asrob-uc3m/ASROB-sumo/hardware/Parts v2/Wheel_v2.FCStd

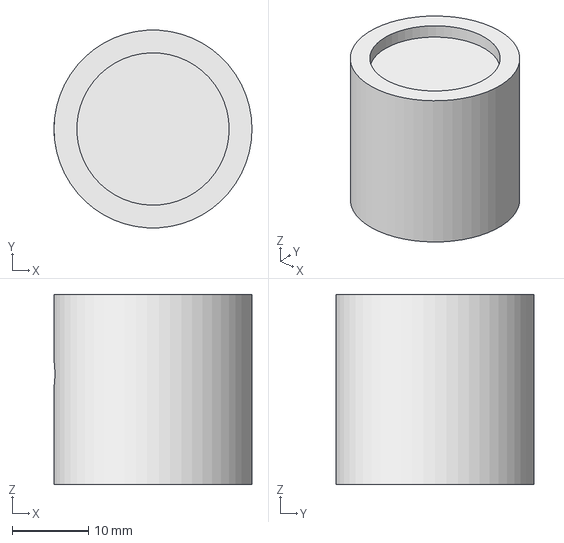
[picture p1: CAD file, 2018-10-18]
hardware/Parts v2/Wheel_v2.FCStd
26.0 x 26.0 x 25.0 mm
