asrob-uc3m/ASROB-sumo/hardware/Printables v2/Engine Bracket_v2.stl

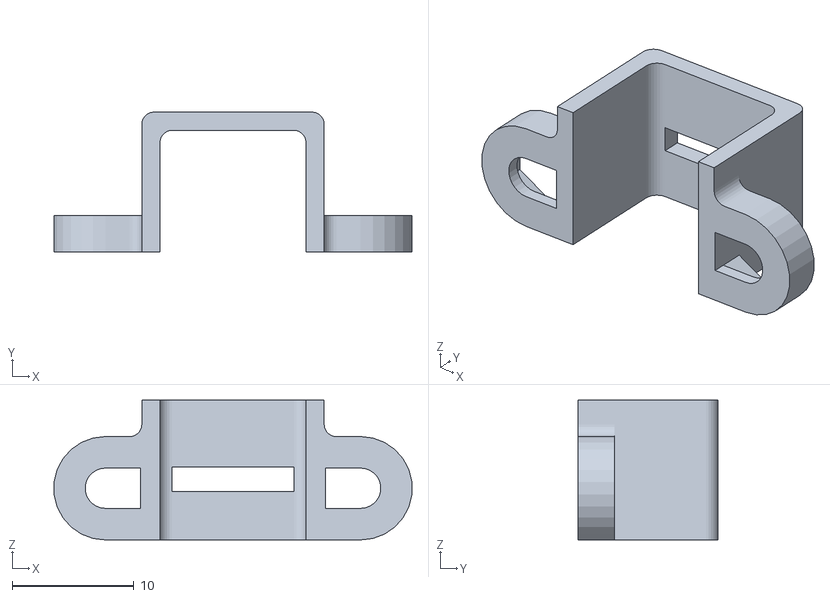
[picture p2: CAD file, 2018-10-18]
hardware/Printables v2/Engine Bracket_v2.stl
29.4 x 11.5 x 11.5
