asrob-uc3m/ASROB-sumo/hardware/Parts v2/Base2_v2.FCStd

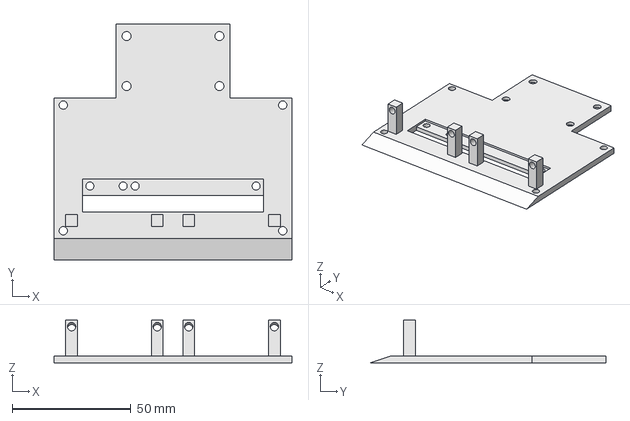
[picture p3: CAD file, 2018-10-18]
hardware/Parts v2/Base2_v2.FCStd
100.0 x 99.0 x 18.0 mm
