asrob-uc3m/ASROB-sumo/hardware/Parts v1/Assembly.FCStd

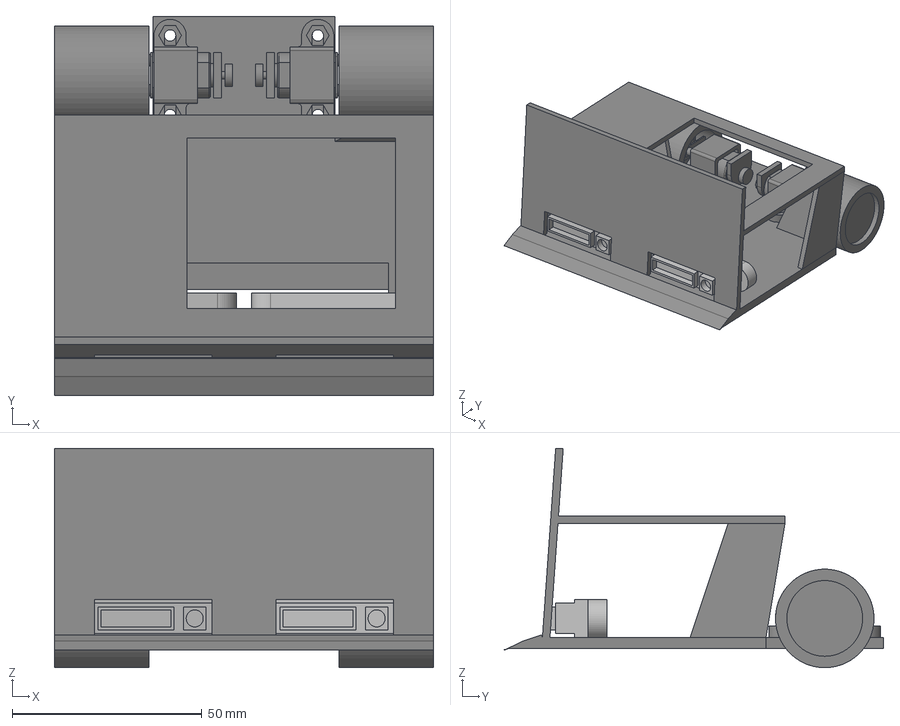
[picture p4: CAD file, 2018-04-15, an earlier design]
hardware/Parts v1/Assembly.FCStd
100.0 x 100.0 x 57.9 mm
