asrob-uc3m/ASROB-sumo/hardware/Parts v1/Sensor.FCStd

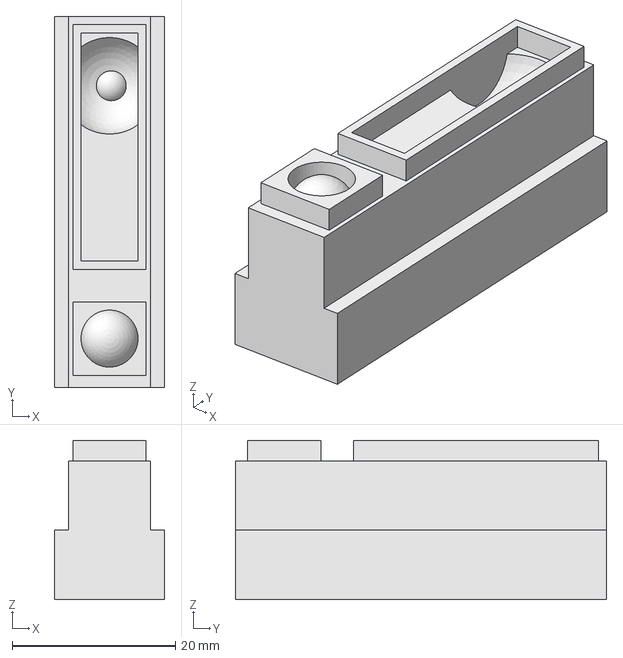
[picture p5: CAD file, 2018-04-15, an earlier design]
hardware/Parts v1/Sensor.FCStd
13.5 x 45.5 x 19.5 mm
