asrob-uc3m/ASROB-sumo/hardware/Printables v1/Structure2.stl

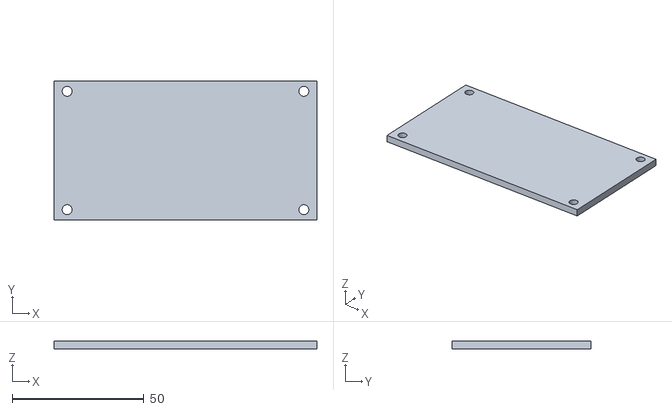
[picture p6: CAD file, 2018-04-15, an earlier design]
hardware/Printables v1/Structure2.stl
100.0 x 53.0 x 3.00
