asrob-uc3m/ASROB-sumo/hardware/Parts v1/Wheel.FCStd

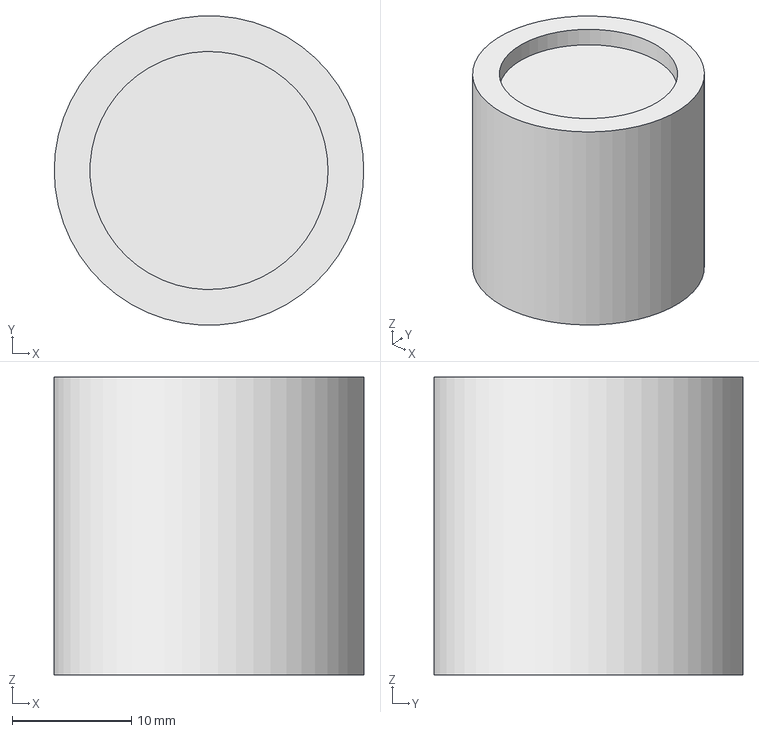
[picture p7: CAD file, 2018-04-15, an earlier design]
hardware/Parts v1/Wheel.FCStd
26.0 x 26.0 x 25.0 mm
