asrob-uc3m/ASROB-sumo/hardware/Printables v1/Structure.stl

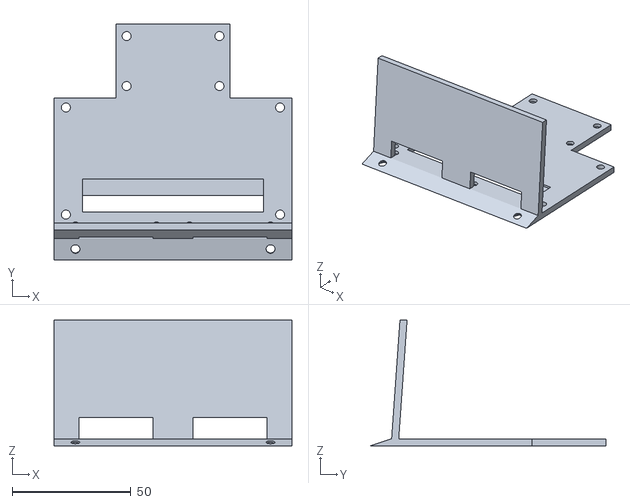
[picture p8: CAD file, 2018-04-15, an earlier design]
hardware/Printables v1/Structure.stl
100.0 x 99.0 x 52.9
