asrob-uc3m/ASROB-sumo/hardware/Parts v1/Base_extra.FCStd

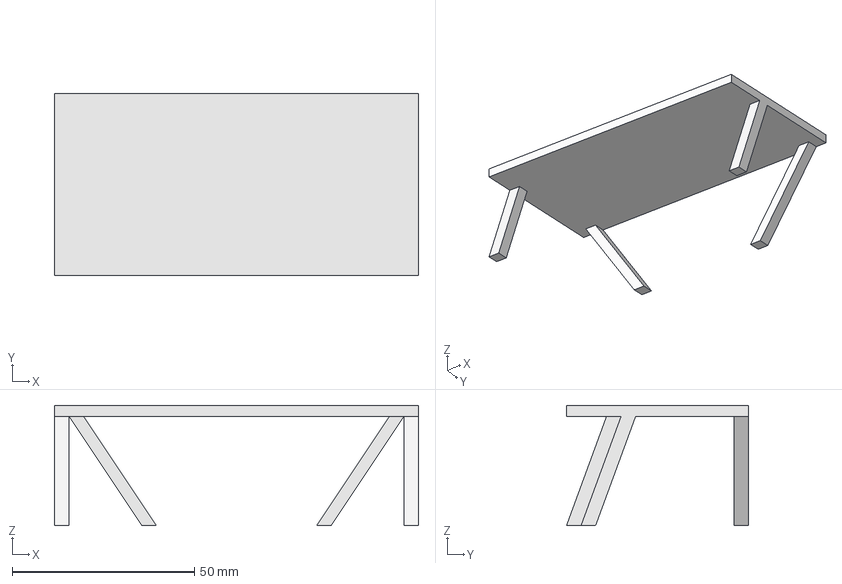
[picture p9: CAD file, 2018-04-15, an earlier design]
hardware/Parts v1/Base_extra.FCStd
100.0 x 50.0 x 33.0 mm
