asrob-uc3m/ASROB-sumo/hardware/Printables v1/Engine Bracket.stl

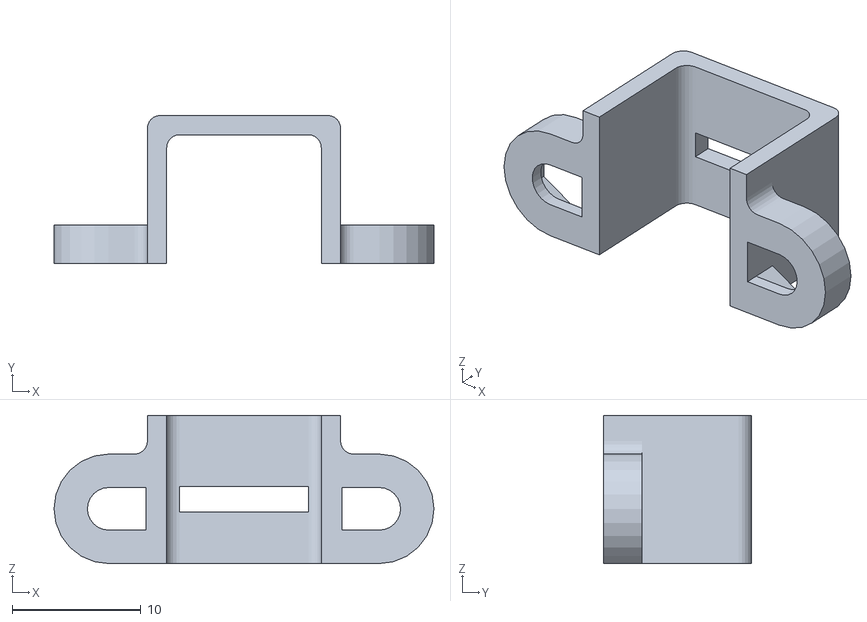
[picture p10: CAD file, 2018-04-15, an earlier design]
hardware/Printables v1/Engine Bracket.stl
29.5 x 11.5 x 11.5
