asrob-uc3m/ASROB-sumo/hardware/Parts v1/Base2.FCStd

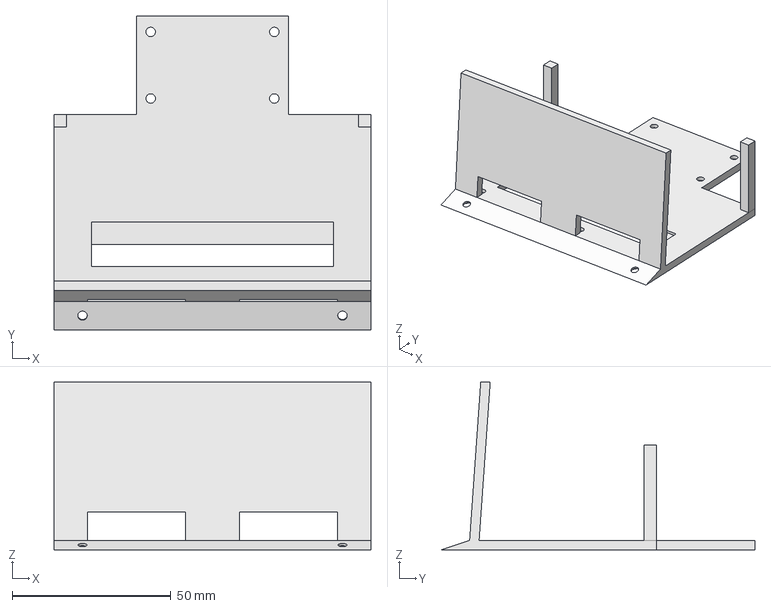
[picture p11: CAD file, 2018-04-15, an earlier design]
hardware/Parts v1/Base2.FCStd
100.0 x 99.0 x 52.9 mm
