asrob-uc3m/ASROB-sumo/hardware/Parts v1/Base.FCStd

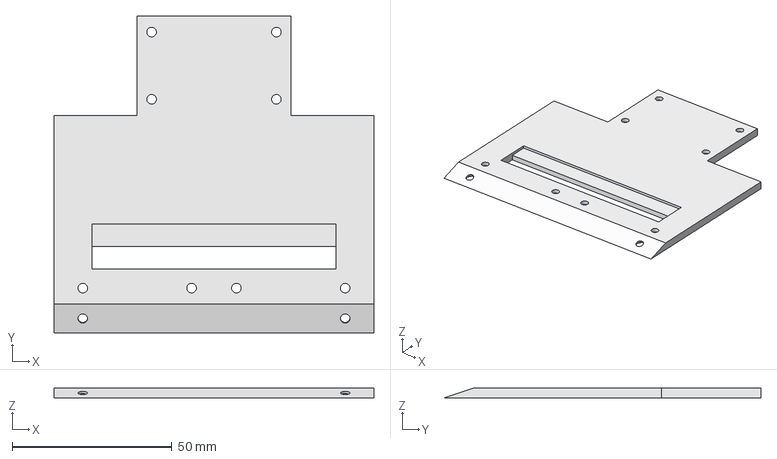
[picture p12: CAD file, 2018-04-15, an earlier design]
hardware/Parts v1/Base.FCStd
100.0 x 99.0 x 3.00 mm
