asrob-uc3m/ASROB-sumo/(list of files, cad)

Other CAD files:
hardware/Parts v2/Engine Bracket_v2.FCStd
hardware/Printables v2/Wheel_v2.stl
hardware/Printables v2/Base2_v2.stl
hardware/Printables v1/Structure2-v2.stl
hardware/Printables v1/Wheel.stl
hardware/Parts v1/Engine Bracket.FCStd
hardware/Parts v1/Blade.FCStd
hardware/Parts v1/Engine.FCStd
