asrob-uc3m/ASROB-sumo/electronics/Sumo/Sumo.kicad_pcb

## KiCad design electronics/Sumo/Sumo.kicad_pcb (2018-05-06)

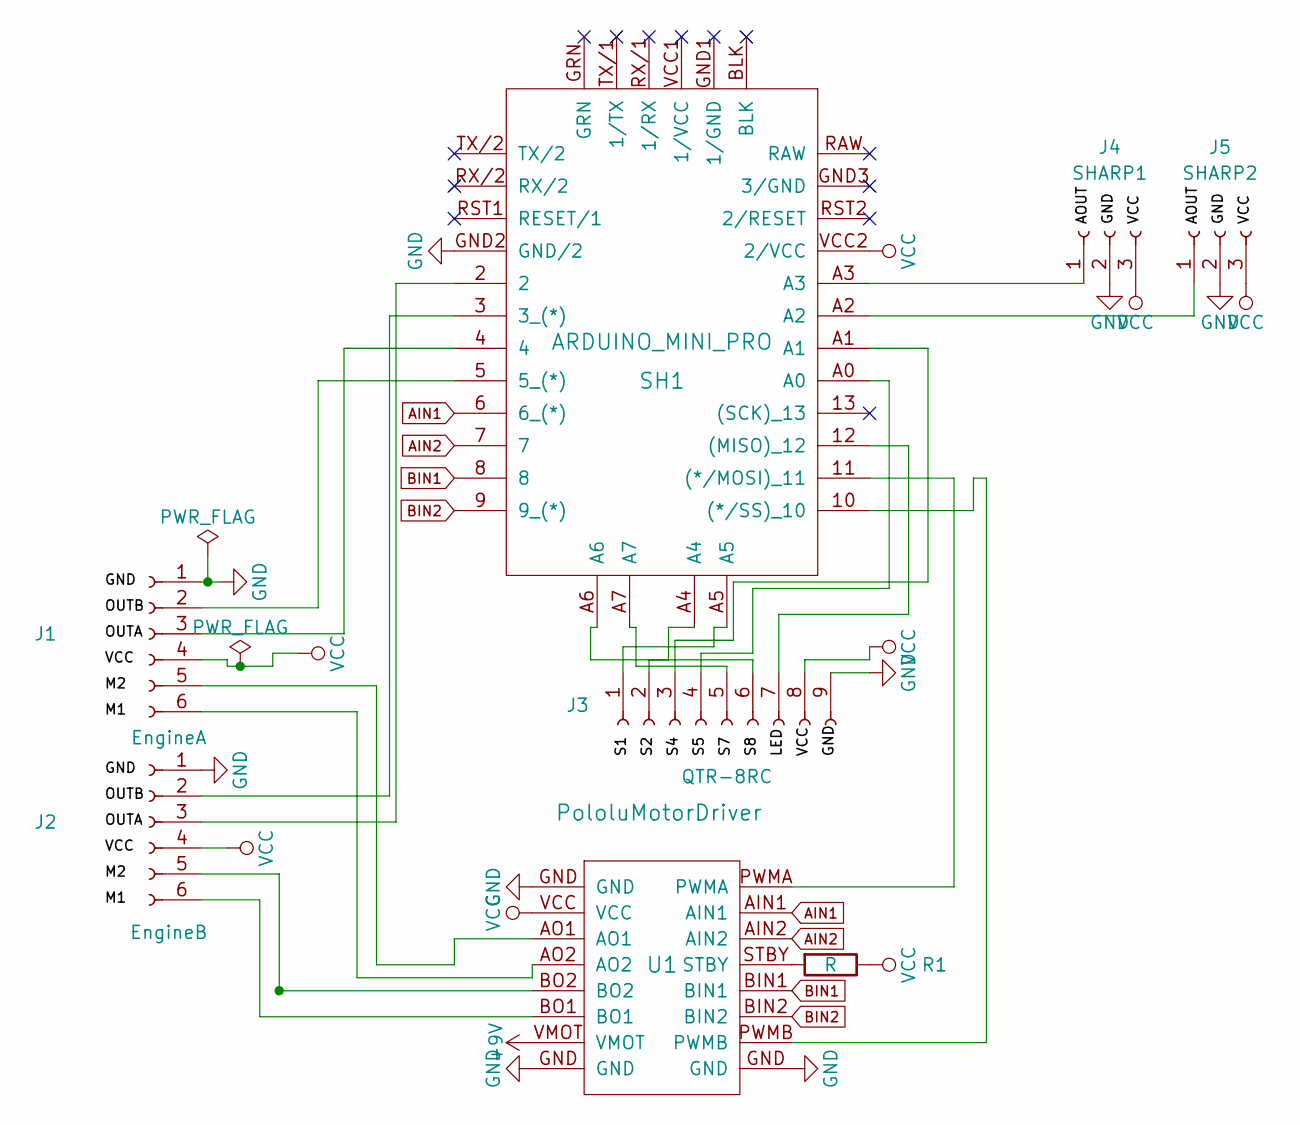
[picture p13: schematic Sumo.sch]

Parts:
J1: EngineA; Socket_Strip_Straight_1x06_Pitch2.54mm
J2: EngineB; Socket_Strip_Straight_1x06_Pitch2.54mm
J3: QTR-8RC; Socket_Strip_Straight_1x09_Pitch2.54mm
J4: SHARP1; Socket_Strip_Straight_1x03_Pitch2.54mm
J5: SHARP2; Socket_Strip_Straight_1x03_Pitch2.54mm
R1: R; R_Axial_DIN0204_L3.6mm_D1.6mm_P5.08mm_Horizontal
SH1: ARDUINO_MINI_PRO; ARDUINO_MINI_PRO_V10
U1: PololuMotorDriver

Connections:
+9V: U1.VMOT
AIN1: SH1.6 (6_(*)), U1.AIN1
AIN2: SH1.7, U1.AIN2
BIN1: SH1.8, U1.BIN1
BIN2: SH1.9 (9_(*)), U1.BIN2
GND: J1.1, J2.1, J3.9, J4.2, J5.2, SH1.GND2 (GND/2), U1.GND
unnamed: J1.2, SH1.5 (5_(*))
unnamed: J1.3, SH1.4
unnamed: J1.5, U1.AO1
unnamed: J1.6, U1.AO2
unnamed: J2.2, SH1.3 (3_(*))
unnamed: J2.3, SH1.2
unnamed: J2.5, U1.BO2
unnamed: J2.6, U1.BO1
unnamed: J3.1, SH1.A5
unnamed: J3.2, SH1.A4
unnamed: J3.3, SH1.A1
unnamed: J3.4, SH1.A0
unnamed: J3.5, SH1.A7
unnamed: J3.6, SH1.A6
unnamed: J3.7, SH1.12 ((MISO)_12)
unnamed: J4.1, SH1.A3
unnamed: J5.1, SH1.A2
unnamed: R1.2, U1.STBY
unnamed: SH1.10 ((*/SS)_10), U1.PWMB
unnamed: SH1.11 ((*/MOSI)_11), U1.PWMA
VCC: J1.4, J2.4, J3.8, J4.3, J5.3, R1.1, SH1.VCC2 (2/VCC), U1.VCC

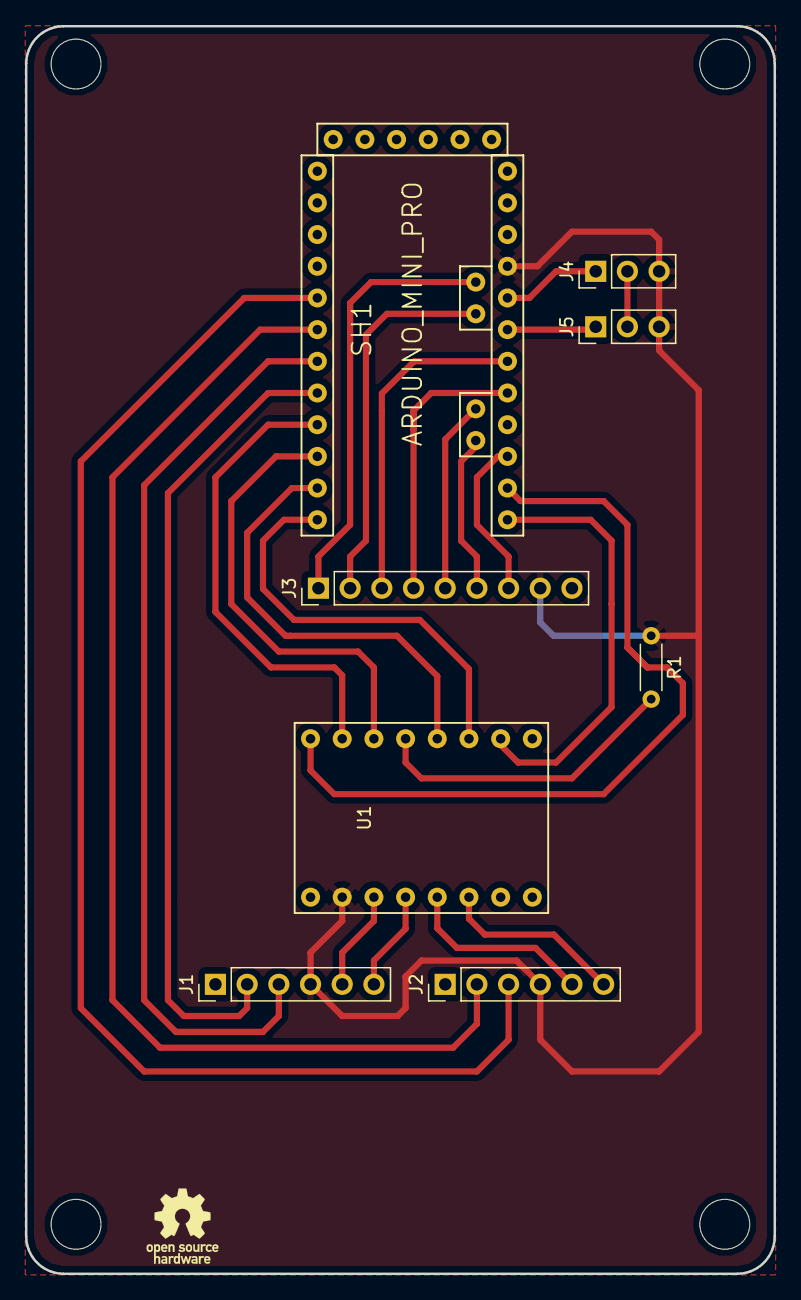
[picture p14: board Sumo.kicad_pcb from above]

Board: 2 copper layers, 60.0 x 100.0 mm, 8 parts (0 on the bottom side), 26 nets.
