asrob-uc3m/ASROB-sumo/(threads)

Thread 1 (2017-11-21):

Subir planos del robot

David-Estevez, 2017-11-21:
Sé que los tenéis, os estoy observando...

Ruben-MR, 2017-11-22:
Ya está subido lo que llevo hecho, tema solucionado, por ahora...

David-Estevez, 2017-11-22:
Bieeeen, ya no se perderán los archivos si le pasa algo a tu pendrive!! :clap:  :clap:  :clap:

Closed 2017-11-22.

Thread 2 (2017-11-29):

Diseñar circuitos del sumo

Ruben-MR, 2017-11-29:
Documentacion de lis distintos elementos usados para la elctronica del sumo y diferentes enlaces a las paginas con informacion para el montaje de los componentes

Ruben-MR, 2017-11-29:
Para control qtr
http://aprendiendofacilelectronica.blogspot.com.es/2014/12/robot-velocista-de-competencia_3.html

Ruben-MR, 2017-11-29:
Conexion sensores sharp
https://www.google.es/search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:

Ruben-MR, 2017-11-29:
Lista de componentes, que quede aqui y no tengamos que andar buscandola todobel rato

[4_6037207379324437263.pdf](https://github.com/asrob-uc3m/ASROB-sumo/files/1514333/4_6037207379324437263.pdf)

Ruben-MR, 2017-11-29:
Conexion del encoder a los motores del sumo
https://mcuoneclipse.com/2014/03/08/processing-the-pololu-motor-shaft-encoders/

Ruben-MR, 2017-11-29:
Instrucciones puemte h
http://learn.teslabem.com/como-armar-un-sumobot/5/

Ruben-MR, 2017-12-13:
Mas informacion para los encoder
[Encoders](http://andrewjkramer.net/motor-encoders-arduino/)

Thread 3 (2017-12-03):

Dohyo

Ruben-MR, 2017-12-03:
Ya tenemos los materiales para preparar el dohyo de los sumos, pero hay que pintarlo poner cinta al borde del ring y tal.

David-Estevez, 2018-04-25:
El próximo día le ponemos la cinta al borde y dejamos esta issue cerrada :muscle:

Thread 4 (2017-12-03):

Dinero materiales dohyo

Ruben-MR, 2017-12-03:
Y con respecto a la otra issue y para que no se me olvide, hay que ver cómo repartir el gasto de los materiales del dohyo. No hay prisa, pero que tampoco se olvide...

David-Estevez, 2017-12-03:
Gracias por poner la issue!! :clap: :clap:  Veamos...

Para empezar, comenta por aquí, para que quede constancia,  de qué materiales estamos hablando y cuánto te costaron.

Para la financiación se me ocurren dos formas:

* Opción 1: hacer bote entre todos los de RoboFactory / grupo de Sumo.
* Opción 2: si queda dinero en la hucha de ASROB, hacer una petición para que se financie desde ahí.

Ruben-MR, 2017-12-03:
Pues en resumidas cuentas seria la madera, que fueron 18 euros en total, por ahora no se ha cogido nada mas. Lo unico que podria hacer falta seria el spray negro para pintarlo y cinta blanca para el borde, pero hasta el momento solo la madera.

David-Estevez, 2018-02-19:
Bueno, para que esto avance, y @Ruben-MR pueda recuperar su dinero, he creado yo la votación en una issue de actas: https://github.com/asrob-uc3m/actas/issues/125

Thread 5 (2018-04-15):

Revisión PCB sumo

Ruben-MR, 2018-04-15:
Adjunto todos los archivos de kicad necesarios para la PCB del sumo para el visto bueno antes de su encargo.

[Sumobot.zip](https://github.com/asrob-uc3m/ASROB-sumo/files/1912191/Sumobot.zip)

Ruben-MR, 2018-04-15:
Ya de paso si es posible echar un vistazo a la parte de la estructura para imprimir, está en el repo, en la branch correspondiente, pero lo subo aquí también.

[FreeCAD.zip](https://github.com/asrob-uc3m/ASROB-sumo/files/1912195/FreeCAD.zip)

Ruben-MR, 2018-04-17:
Perfecto, le echaré un vistazo a esas dos cosas, gracias.
Dejaré la issue abierta para una vez hechos los cambios, dar el visto bueno final antes de encargarla.

David-Estevez, 2018-04-17:
Me parece bien. Si tienes alguna duda coméntamela!

Ruben-MR, 2018-04-24:
Ya está subida la nueva versión de la placa, está en un zip. Lo único que falta por rematar es el tema del logo que me ha resultado tarea imposible.

David-Estevez, 2018-05-03:
No sé si he revisado la última versión, pero tienes una pista sin conectar (VCC).

Ruben-MR, 2018-05-03:
Los documentos están en un zip llamado PCB sumo v2. Lo de esa conexión VCC es básicamente que no hay forma de unirla, hablamos de si eso hacer un puente con un cable extra.

David-Estevez, 2018-05-03:
...o usar la otra cara de la PCB? :wink:

Ruben-MR, 2018-05-03:
Ya está resubido con el problemilla coregido, la cara trasera estaba ocupada en su totalidad por la zona de  relleno de GND, pero ya está hecho un apaño, esperemos que ya esté.

David-Estevez, 2018-05-06:
Revisión subida: https://github.com/asrob-uc3m/ASROB-sumo/pull/10

David-Estevez, 2018-05-10:
Todo ok!

Closed 2018-05-10.

Thread 9 (2018-04-17):

Organizar el repo

David-Estevez, 2018-04-17:
Me está asaltando el TOC al ver todo en la misma carpeta... te importa que lo ordene un poco @Ruben-MR ??

Ruben-MR, 2018-04-17:
Adelante, yo no lo he hecho porque no tengo muy claro cómo.
Lo agradecería también ahora que lo mencionas...

David-Estevez, 2018-05-03:
Lo he hecho en la rama `limpieza`. Échale un ojo a ver si te parece todo ok y si te mola lo mergeamos a master.

Ruben-MR, 2018-05-03:
Está perfectamente, podemos proceder a combinar. Gracias.

David-Estevez, 2018-05-03:
Hecho en 1cc65b2  A partir de ahora, trabajemos sobre esos ficheros!

Closed 2018-05-03.

Thread 11 (2018-05-14):

Re-revisión PCB

Ruben-MR, 2018-05-14:
Con motivo del reciente descubrimiento de un par de fallos en la PCB de los cuales no nos habíamos (me había) percatado hasta ahora, "reabro" la issue para la corrección de dichos fallos y hasta que  la PCB llegue a la asociación.

Los fallos comentados eran la falta de una conexión para le botón de  puesta en marcha del robot y la conexión de las baterías a la conexión correcta.

Dichos fallos ya han sido solventados y queda a la espera de revisión, ahora sí que sí definitiva (esperemos).
