asrob-uc3m/ASROB-sumo/(commit log)

2017-11-22 Primer diseño de piezas en 3D
    Primer diseño 3D de algunas de las pieza del sumo, algunas de las cuales necesitan ser impresas como chasis del robot. Resubiré los modelos acabados y el modelo ensamblado más adelante.
    [Base.FCStd, Blade.FCStd, Engine Bracket.FCStd, Engine.FCStd, Sensor.FCStd, Wheel.FCStd]
2017-12-03 Nueva version 3D de las partes para imprimir
    Version (esperemos) definitiva de las partes para imprimir del sumo y el ensamblaje, una de las piezas de la estructura es distinta al ensamblaje, pero este último es para hacerse una idea del resultado. Lo que importa son las piezas Base2 y Base_extra.
    [Assembly.FCStd, Base2.FCStd, Base_extra.FCStd]
2018-02-03 Imprimibles
    Ficheros en formato STL de las distintas piezas para imprimir, modificadas para dejar algo de margen a la impresora 3d en los distintos huecos para tornillos, tuercas y el eje del motor.
    [Engine Bracket.stl, Structure.stl, Structure2.stl, Wheel.stl]
2018-03-14 Alpha version
    La versión inicial del codigo del sumo, contiene las funciones de movimiento, el calibrado de los sensores y la asignación de los pines, que es la parte más tediosa. Subido para que lo vayan mjorando los otros componentes del grupo.
2018-03-15 PCB test funcionalidad
    Esquema de PCB aleatorio para solucionar problemas kicad
    [test.kicad_pcb, test.sch]
2018-04-10 Nueva version chasis
    Segunda versión del chasis del sumo, más "apta" para impresión que la primera.
    [Structure2-v2.stl]
2018-04-15 Versión revisión PCB
    Primera versión de la PCB lista para revisión, todos los archivos se encuentran en el archivo ZIP.
2018-04-24 Nueva versión de la PCB
    Nueva versión de la PCB con la mayoría de los cambios que hemos comentado en las reuniones, taladros, finalización de la región de cobre para el gnd, algunas conexiones sueltas y el nombre del robot y dirección al github. Falta el logo, adjunto en el zip.
2018-05-03 Limpiar el repo
    [Assembly.FCStd, Base.FCStd, Base2.FCStd, Base_extra.FCStd, Blade.FCStd, Engine Bracket.FCStd, Engine Bracket.stl, Engine.FCStd]
2018-05-03 PCB v-final
    Última versión (esperemos) de la placa, como en la versión anterior, solo queda introducir el logo y encargarla
2018-05-06 Add files to control version
    [Sumo.kicad_pcb]
2018-05-06 Fix traces, add rounded edges, add mounting holes
    [Sumo.kicad_pcb]
2018-05-06 Add logo to PCB
    [Sumo.kicad_pcb]
2018-10-18 Updated and organized hardware
    New versions of the sumo components have been included. New wheel prevents the shaft from slipping, the base has new holes for attaching the PCB and the SHARP sensors in a beter position, and the engine bracket includes a gap to keep the encoder cables tight to the encoder.
    New organization of the differentt version, including printables has been done.
    [Assembly.FCStd, Base.FCStd, Base2.FCStd, Base2_v2.FCStd, Base2_v2.stl, Base_extra.FCStd, Blade.FCStd, Engine Bracket.FCStd]
